louisonmalinge/Projet-Velux/Prototypage/BOM Projet Velux.xlsx

 |  |  |  |  |  |  |  | SOURCING |  |  |  |  |  | ACHATS
Référence | Description | Boitier | Fabricant | Part Number | Fournisseur | Réf fournisseur | Qty total | Fournisseur | Ref Four | Qté à Commander | Unit Price | Total Price | Sourceur | Commentaire | Acheteur | Commande | Datedecommande | Datelivraisonestimée | DateRéception
LMR51625YFDDCR (https://www.mouser.fr/ProductDetail/Texas-Instruments/LMR51625YFDDCR?qs=efUn273yAhe0Di9PgWnVVg%3D%3D) | Régulateurs de tension de commutation SIMPLE SWITCHER sync hronous buck conver |  | Texas Instruments (https://www.mouser.fr/manufacturer/texas-instruments/) | 296-LMR51625XDDCRCT-ND | digikey | LMR51625YFDDCR | 5 | digikey | LMR51625YFDDCR | 5 | 1.7100 € | 8.5500 € | Achat
RP73D2B10K2BTG (https://fr.farnell.com/holsworthy-te-connectivity/rp73d2b10k2btg/res-couche-mince-10k2-0-1-0-25w/dp/1501710RL) | Résistance à puce CMS, 10.2 kohm, ± 0.1%, 250 mW, 1206 [3216 Metric], Couche mince, Précision |  | HOLSWORTHY - TE CONNECTIVITY (https://fr.farnell.com/c/composants-passifs/resistances-valeur-fixe/resistances-cms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) |  | farnell | 1501710RL | 10 | farnell | 1501710RL | 10 | 0.6365 € | 6.3648 € | Achat
SPM4020T-4R7M-LR (https://fr.farnell.com/tdk/spm4020t-4r7m-lr/inductance-4-7uh-2-5a-20-bobinee/dp/2564035) | Inductance de puissance (CMS), Bobiné, 4.7 µH, 2.5 A, Blindé, 3.5 A, SPM-LR Series |  | TDX |  | farnell | 2564035 | 10 | farnell | 2564035 | 10 | 0.7046 € | 7.0464 € | Achat
C0603T104K4RACTU (https://fr.farnell.com/kemet/c0603t104k4ractu/condensateur-0-1-f-16v-10-x7r/dp/2904876) | Condensateur céramique multicouche CMS, 0.1 µF, 16 V, 0603 [Métrique 1608], ± 10%, X7R |  | KEMET |  | farnell | 2904876 | 10 | farnell | 2904876 | 10 | 0.3811 € | 3.8112 € | Achat
CGA4J3X7R1E225M125AE (https://fr.farnell.com/tdk/cga4j3x7r1e225m125ae/condensateur-2-2uf-25v-mlcc-0805/dp/4066733) | Condensateur céramique multicouche CMS, 2.2 µF, 25 V, 0805 [Métrique 2012], ± 20%, X7R |  | TDX |  | farnell | 4066733 | 5 | farnell | 4066733 | 5 | 0.3725 € | 1.8624 € | Achat
10 ensembles 20 ensembles lot 2.5MM pas 5264 (https://www.amazon.fr/bo%C3%AEtiers-femelles-aiguille-connecteur-fil-carte/dp/B0FRF74GVY?th=1) | Lot de 10/20 boîtiers femelles 5264 au pas 2,54 × 0,5 mm + aiguille droite/courbée + borne 2P à 12 broches 5268 for connecteur PCB fil-carte(Curver set-10sets,3P) |  | HamPaesk (https://www.amazon.fr/s/ref=bl_dp_s_web_0?ie=UTF8&search-alias=aps&field-keywords=HamPaesk) |  | Amazon |  | 1 | Amazon |  | 1 | 12.680 € | 12.6800 € | Achat
CRCW120653K6FKEA (https://fr.farnell.com/vishay/crcw120653k6fkea/res-couche-epaisse-53-6k-1-0-25w/dp/1653147) | Résistance à puce CMS, 53.6 kohm, ± 1%, 250 mW, 1206 [3216 Metric], Couche épaisse, Usage Général |  | VISHAY |  | farnell | 1653147 | 10 | farnell | 1653147 | 10 | 0.033 € | 0.3280 € | Achat
FCR7350R (https://www.digikey.com/en/products/detail/cliff-electronic-components-ltd/FCR7350R/17729035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) | 4MM PANEL SKT S16N-PC RED |  | CLIFF Electronic Components Ltd |  | digikey | 4654-FCR7350R-ND | 1 | digikey | 4654-FCR7350R-ND | 1 | 4.780 € | 4.7800 € | Achat
FCR7350B (https://www.digikey.com/en/products/detail/cliff-electronic-components-ltd/FCR7350B/17729030) | 4MM PANEL SKT S16N-PC BLACK |  | CLIFF Electronic Components Ltd |  | digikey | 4654-FCR7350B-ND | 1 | digikey | 4654-FCR7350B-ND | 1 | 4.780 € | 4.7800 € | Achat
RB141C1100 (https://www.digikey.fr/fr/products/detail/e-switch/RB141C1100/3778081) | Interrupteurs à bascule SPST 15A (CA) 125 V Montage sur panneau à enclenchement |  | E-Switch (https://www.digikey.fr/fr/supplier-centers/e-switch) |  | digikey | EG5637-ND | 1 | digikey | EG5637-ND | 1 | 0.850 € | 0.8500 € | Achat
820-7561 (https://ma.rsdelivers.com/product/rs-pro/commutateur-a-bouton-poussoir-spst-rs-pro-montage/8207561) | Commutateur à bouton-poussoir, SPST RS PRO, Montage sur circuit imprimé, Momentanée 13.6 mm IP40, LED Vert 50 V |  | RS PRO (https://ma.rsdelivers.com/productlist/search?query=rs%20pro) |  | RS Pro | 820-7561 | 1 | RS Pro | 820-7561 | 1 | 4.440 € | 4.4400 € | Achat
RUNCCI-YUN 60Pièces (https://www.amazon.fr/RUNCCI-YUN-60Pi%C3%A8ces-Femelle-Connecteur-Empilable/dp/B0FDQQ21SW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) | RUNCCI-YUN 60Pièces 2.54mm PCB Carte Femelle Broche Connecteur Socket (4/6/8/10/12/16/20/40 Pin) Femelle Pin Header Socket Connecteur Bande, pour Arduino Empilable Shield |  | RUNCCI-YUN (https://www.amazon.fr/RUNCCI-YUN/b?node=21909514031&field-lbr_brands_browse-bin=RUNCCI-YUN) |  | Amazon |  | 1 | Amazon |  | 1 | 9.990 € | 9.9900 € | Achat
GRM21BR61C226ME44L (https://fr.farnell.com/murata/grm21br61c226me44l/condensateur-22-f-16v-20-x5r-0805/dp/2688534) | CONDENSATEUR, 22µF, 16V, 20%, X5R, 0804 |  | MURATA |  | farnell | 2688534 | 10 | farnell | 2688534 | 10 | 0.284 € | 2.8416 € | Achat
Arduino Module nano 33 IOT (https://fr.farnell.com/arduino/abx00027/carte-dev-nano-33-iot-mcu-arm/dp/3404692) | ABX00027 |  | Arduino |  | farnell | 3404692 | 1 | farnell | 192-7585 | 1 | 17.584 € | 17.5840 € | Achat
 |  |  |  |  |  |  |  |  |  |  | Total | 85.91 €
