louisonmalinge/Projet-Velux/Prototypage/Choix des composants.xlsx

Sheet: Feuil2
Nom | Référence | Lien | Nombre | Prix
Convertisseur Buck | LMR51625XFDDCR | LMR51625XFDDCR Texas Instruments | Mouser France (https://www.mouser.fr/ProductDetail/Texas-Instruments/LMR51625XFDDCR?qs=efUn273yAhedqu6JOAiMBw%3D%3D) | 1 | 2.69 € | Prix totale | 56.07 €
Condensateur | C2012X5R1A336M125AC | C2012X5R1A336M125AC TDK, Condensateur céramique multicouche CMS, 33 µF, 10 V | Farnell® France (https://fr.farnell.com/tdk/c2012x5r1a336m125ac/condensateur-33-f-10v-20-x5r-0805/dp/2525132) | 2 | 1,71 €
Résistance | MCWF12R3162BTL Résistance à puce CMS, 31.6 kohm, ± 0.1%, 250 mW, 1206 [3216 Metric], Couche mince, Précision | MCWF12R3162BTL MULTICOMP PRO, Résistance à puce CMS, 31.6 kohm, ± 0.1% | Farnell® France (https://fr.farnell.com/multicomp-pro/mcwf12r3162btl/res-couche-mince-31-6k-0-1-0-25w/dp/2338454) | 1 | 1.84 €
Résistance | RP73D2B10K2BTG Résistance à puce CMS, 10.2 kohm, ± 0.1%, 250 mW, 1206 [3216 Metric], Couche mince, Précision | RP73D2B10K2BTG HOLSWORTHY - TE CONNECTIVITY, Résistance à puce CMS, 10.2 kohm, ± 0.1% | Farnell® France (https://fr.farnell.com/holsworthy-te-connectivity/rp73d2b10k2btg/res-couche-mince-10k2-0-1-0-25w/dp/1501710RL) | 1 | 0.37 €
Bobine | B82477G4103M000 Inductance de puissance (CMS), 10 µH, 5.4 A, Blindé, 6.4 A, B82477G4 Series | B82477G4103M000 EPCOS, Inductance de puissance (CMS), 10 µH, 5.4 A | Farnell® France (https://fr.farnell.com/epcos/b82477g4103m000/inductance-de-puissance-10uh/dp/7430353) | 1 | 1.63 €
Condensateur | C0603T104K4RACTU Condensateur céramique multicouche CMS, 0.1 µF, 16 V, 0603 [Métrique 1608], ± 10%, X7R | C0603T104K4RACTU KEMET, Condensateur céramique multicouche CMS, 0.1 µF, 16 V | Farnell® France (https://fr.farnell.com/kemet/c0603t104k4ractu/condensateur-0-1-f-16v-10-x7r/dp/2904876) | 1 | 0.44 €
Condensateur | CS1206KKX7R8BB225 Condensateur céramique multicouche CMS, 2.2 µF, 25 V, 1206 [Métrique 3216], ± 10%, X7R | CS1206KKX7R8BB225 YAGEO, Condensateur céramique multicouche CMS, 2.2 µF, 25 V | Farnell® France (https://fr.farnell.com/yageo/cs1206kkx7r8bb225/condensateur-2-2uf-25v-mlcc-1206/dp/3890070) | 1 | 0.22 €
Interrupteur | Interrupteur à bascule unipolaire On-Off, , 16 A | PRASA1-16F-BB0BW | Interrupteur à bascule unipolaire On-Off, , 16 A | RS (https://fr.rs-online.com/web/p/interrupteurs-a-bascule/7182247) | 1 | 1.83 €
Bouton Poussoir | Bouton-poussoir, Momentané, SPST, 65 mA, Montage panneau | FL13NN | Bouton-poussoir, Momentané, SPST, 65 mA, Montage panneau | RS (https://fr.rs-online.com/web/p/boutons-poussoirs/9131762) | 1 | 8.56 €
Écran OLED | MDOB128064WV-YBI OLED graphique, 128 x 64 pixels, jaune/bleu sur noir, 3.3V, I2C, 27.3mm x 27.3mm, -40 °C | MDOB128064WV-YBI MIDAS DISPLAYS, OLED graphique, 128 x 64 pixels, jaune/bleu sur noir | Farnell® France (https://fr.farnell.com/midas/mdob128064wv-ybi/oled-graphique-cob-128-x-64-pixels/dp/3565084) | 1 | 12.74 €
Connecteur( arduino/module ethernet/écran) | VooGenzek 120 Pièces 2.54mm PCB Carte Femelle Broche Connecteur Socket Kit, Pin Header Socket Bande, pour Arduino Empilable Shield (4/6/8/10/12/16/20/40 Pin) | https://www.amazon.fr/VooGenzek-Femelle-Connecteur-Arduino-Empilable/dp/B09NDMVD2C?hvadid=80470714387312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 | 1 | 11.99 €
Conecteur cable banane noir | SWEB 8094 AU / SW Connecteur de test banane, Femelle, Montage PCB, 24 A, 1 kV, Contacts plaqués or, Noir | SWEB 8094 AU / SW SCHUTZINGER, Connecteur de test banane, Femelle, Montage PCB | Farnell® France (https://fr.farnell.com/schutzinger/sweb-8094-au-sw/conn-banane-femelle-24a-noir/dp/3224814) | 1 | 6.20 €
Conecteur cable banane rouge | SWEB 8094 AU / RT Connecteur de test banane, Femelle, Montage PCB, 24 A, 1 kV, Contacts plaqués or, Rouge | SWEB 8094 AU / RT SCHUTZINGER, Connecteur de test banane, Femelle, Montage PCB | Farnell® France (https://fr.farnell.com/schutzinger/sweb-8094-au-rt/fiche-banane-femelle-24a-rouge/dp/3224813) | 1 | 6.20 €
Connecteur Panneau Solaire | 10 ensembles 20 ensembles lot 2.5MM pas 5264 boîtier femelle + aiguille droite/incurvée + Terminal 2P ~ 12P 5268 pour connecteur fil à carte PCB (https://fr.aliexpress.com/item/1005003049892868.html?gatewayAdapt=kor2fra) | 10 ensembles 20 ensembles lot 2.5MM pas 5264 boîtier femelle + aiguille droite/incurvée + Terminal 2P ~ 12P 5268 pour connecteur fil à carte PCB - AliExpress 13 (https://fr.aliexpress.com/item/1005003049892868.html?gatewayAdapt=kor2fra) | 1 | 1.35 €
 |  | Connecteur 2 cosses avec broches mâle et femelle Brazoline - Atelier & Stand sur La Bécanerie (https://www.la-becanerie.com/connecteur-2-cosses-avec-broches-male-et-femelle-brazoline.html)

Sheet: Feuil1
Référence | Lien
