louisonmalinge/Projet-Velux/Plan de test/Fiche anomalie/Prcoédure de test Wireshark.pdf

### Brevet de Technicien Supérieur CIEL

Session 2026
Saint Aubin la Salle

# Procédure de test WIRESHARK

# MALINGE Louison ST2ER

1. Ouvrir l’application Wireshark sur le PC et éteindre le banc de test en appuyant sur l’interrupteur situé sur la face avant du banc de test.

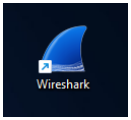
[picture p37: figure]

2. Une fois ouverte, cliquer sur Ethernet :

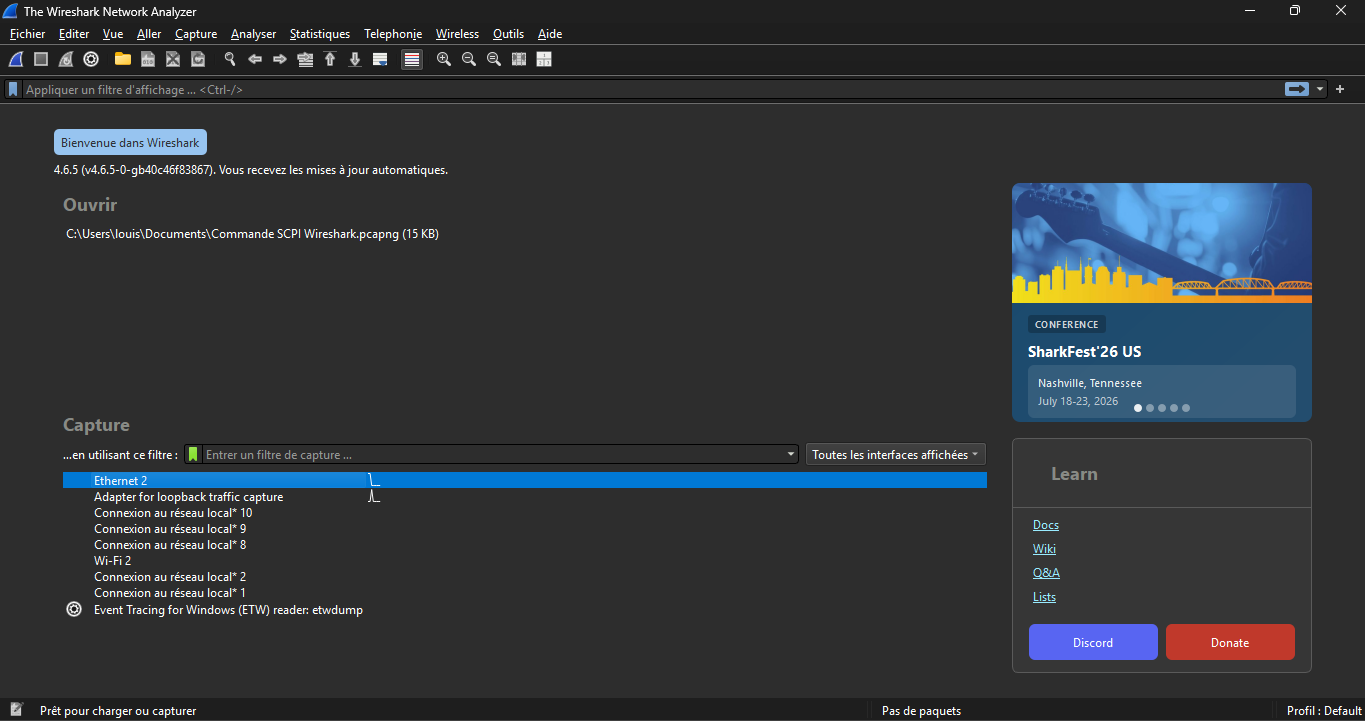
[picture p38: figure]
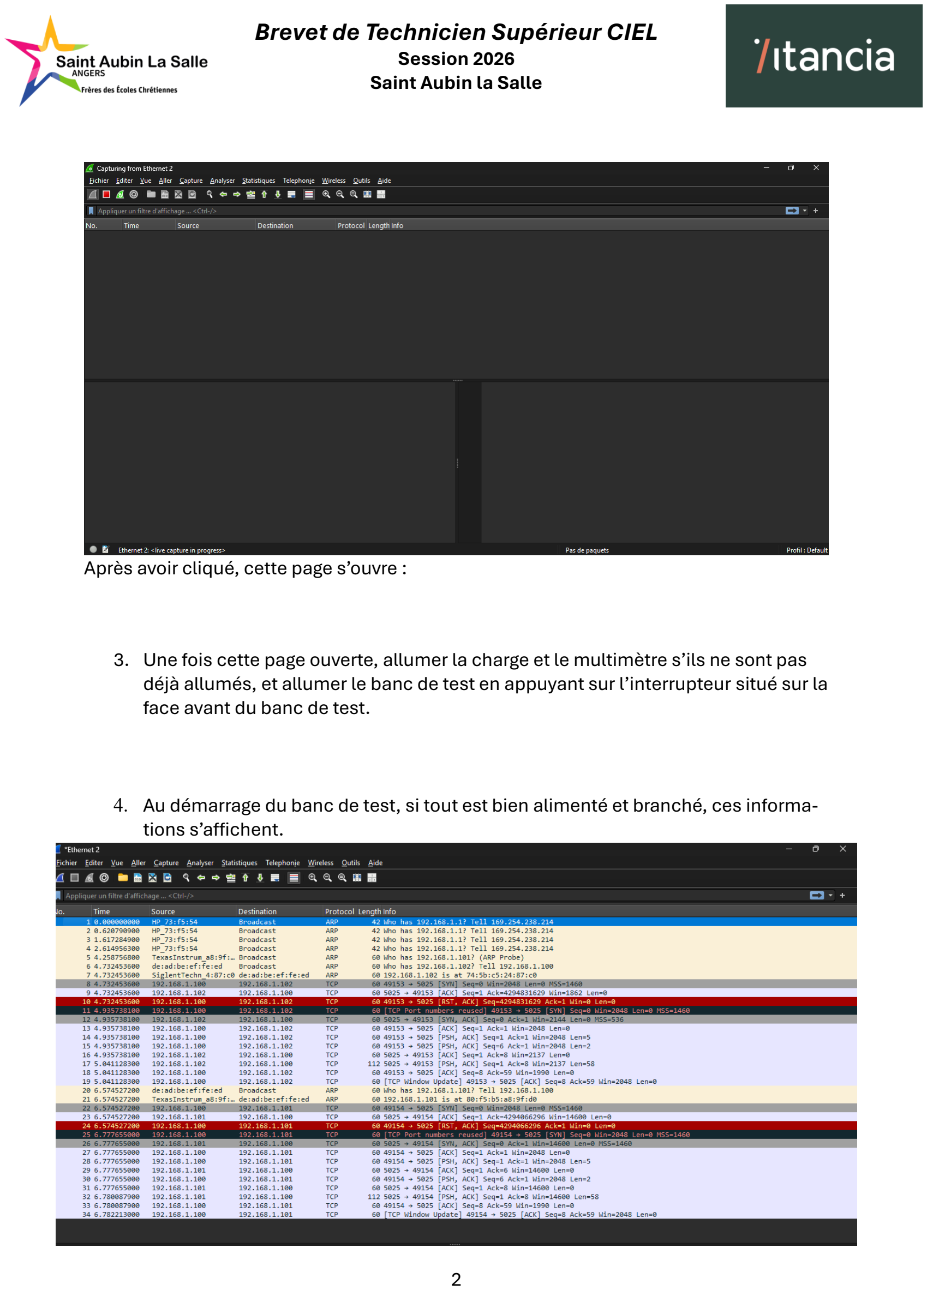
[picture p39: page 2]

Après avoir cliqué, cette page s’ouvre :

3. Une fois cette page ouverte, allumer la charge et le multimètre s’ils ne sont pas déjà allumés, et allumer le banc de test en appuyant sur l’interrupteur situé sur la face avant du banc de test.
4. Au démarrage du banc de test, si tout est bien alimenté et branché, ces informations s’affichent.

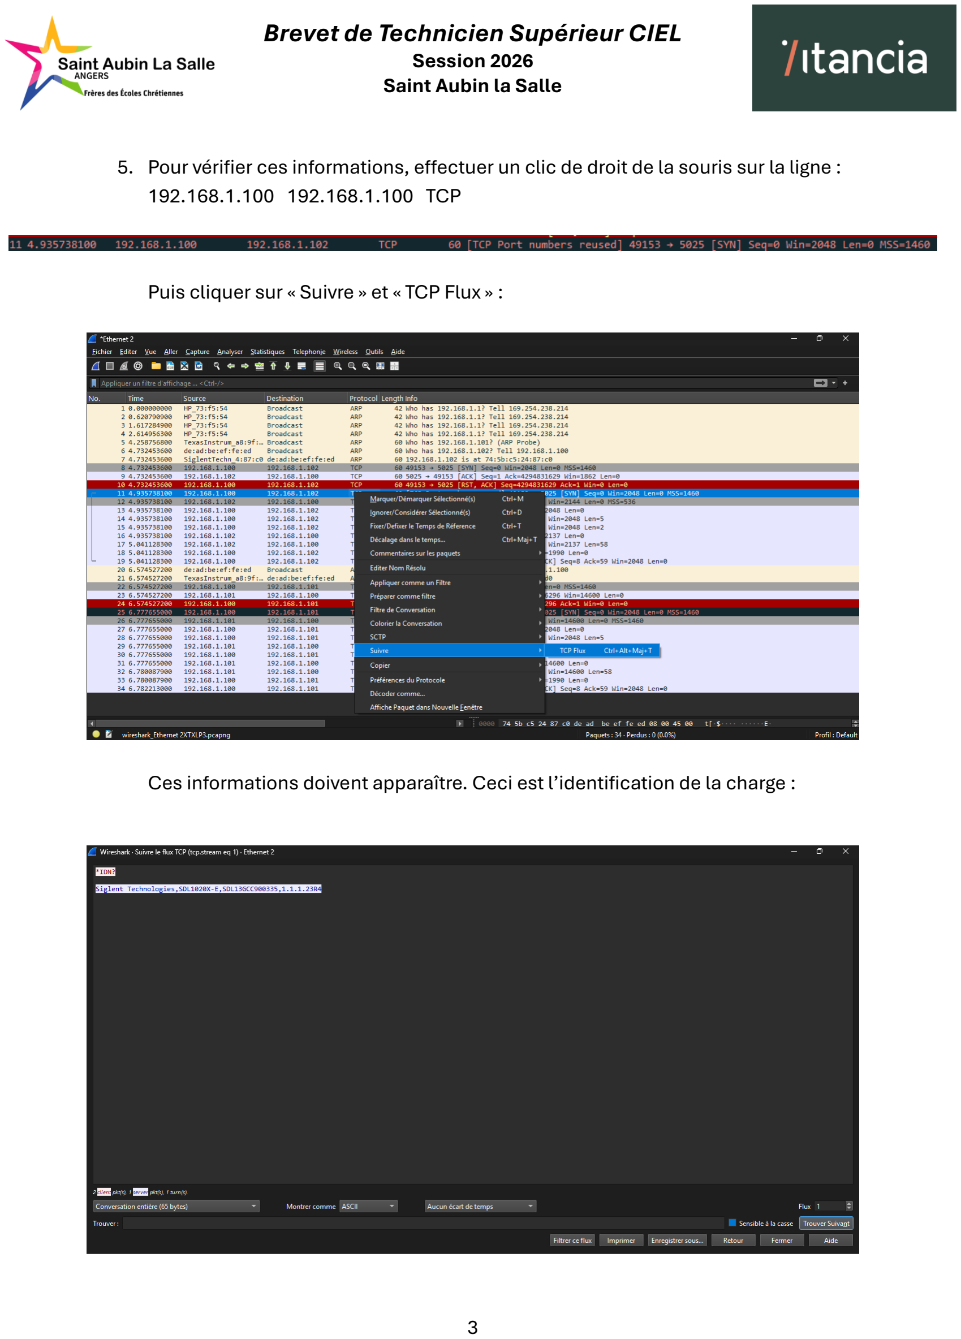
[picture p40: page 3]

5. Pour vérifier ces informations, effectuer un clic de droit de la souris sur la ligne : 192.168.1.100 192.168.1.100 TCP

Puis cliquer sur « Suivre » et « TCP Flux » :

Ces informations doivent apparaître. Ceci est l’identification de la charge :

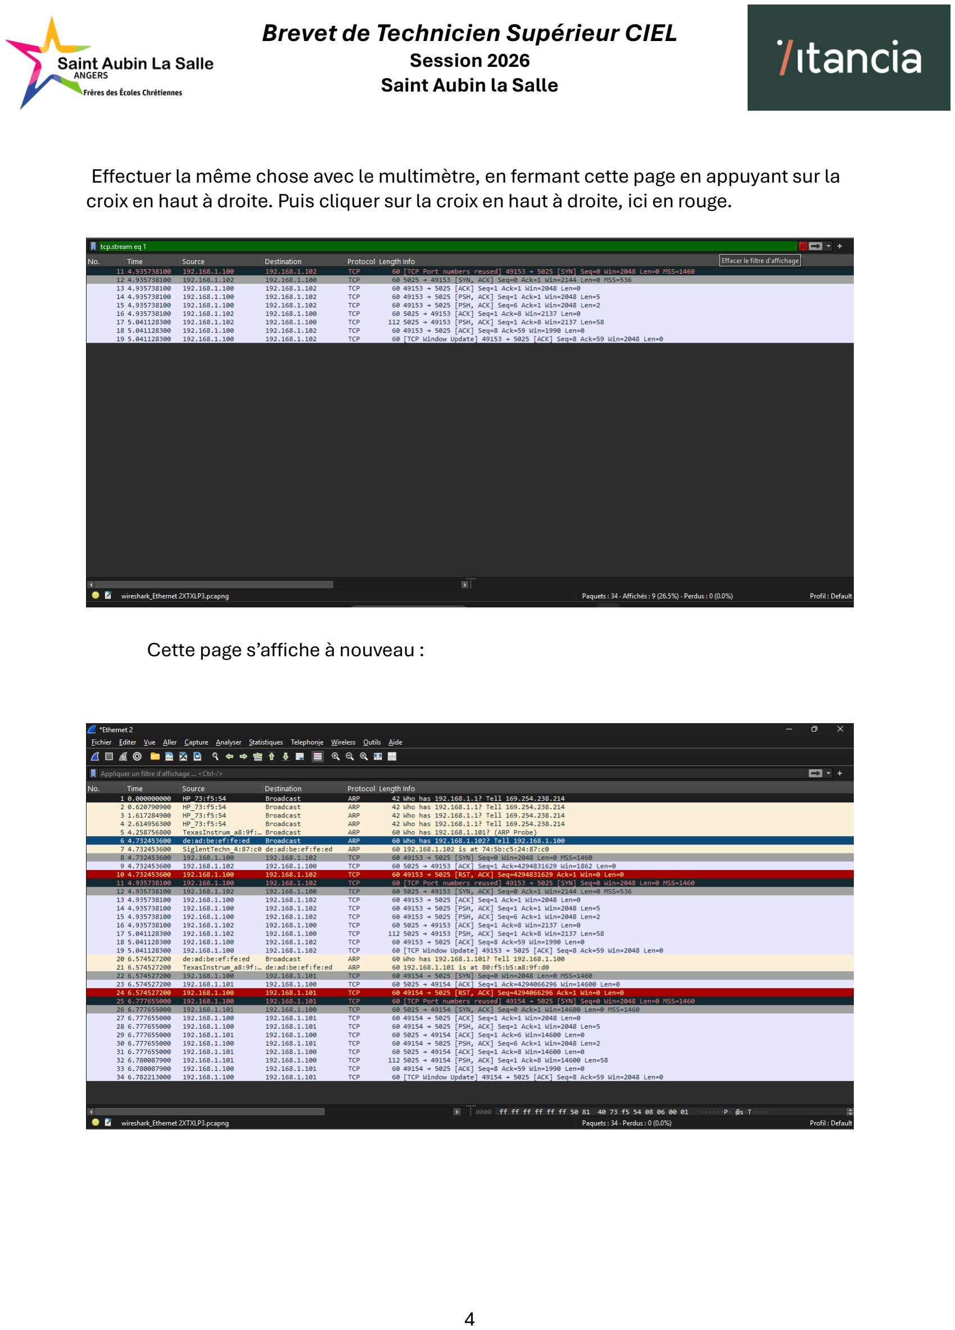
[picture p41: page 4]

Effectuer la même chose avec le multimètre, en fermant cette page en appuyant sur la croix en haut à droite. Puis cliquer sur la croix en haut à droite, ici en rouge.

Cette page s’affiche à nouveau :

Effectuer la même procédure que précédemment en effectuant un clic droit sur la deuxième ligne en noir. Puis « Suivre », « TCP Flux » et obtenir cette page :

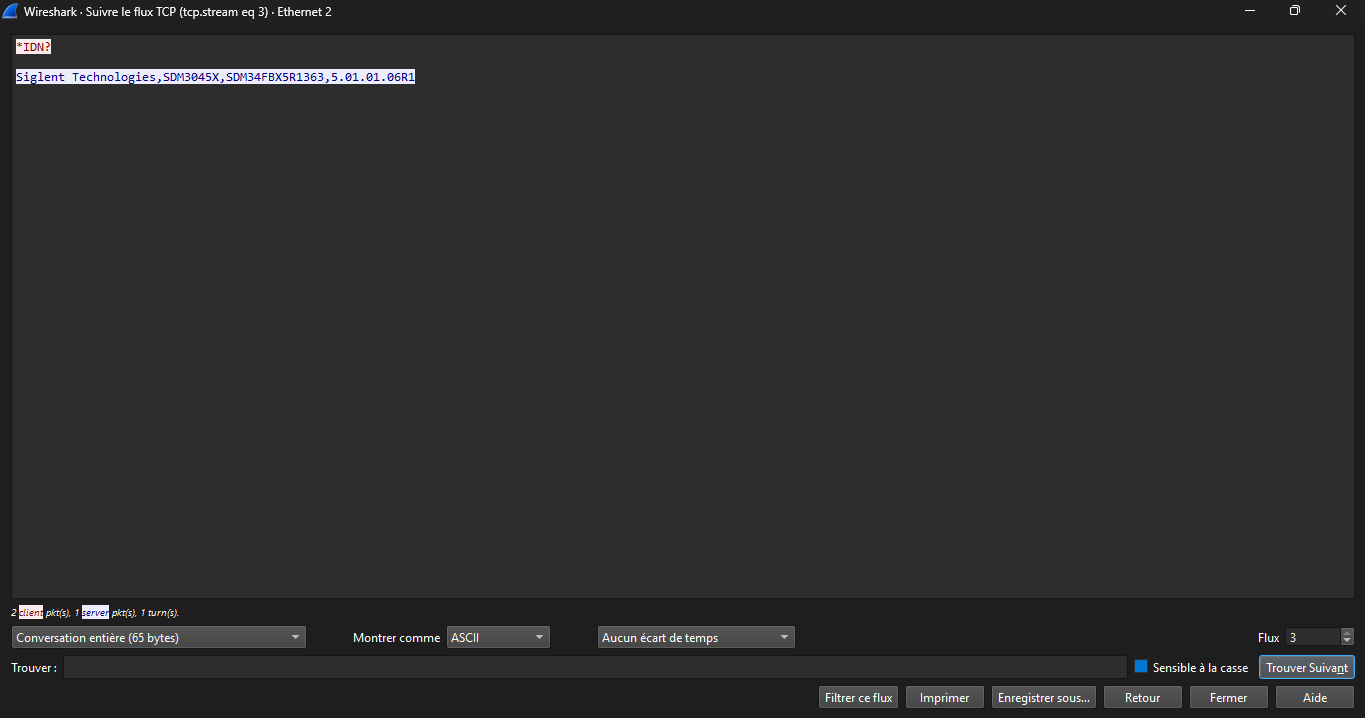
[picture p42: figure]

Ces informations sont l’identification du multimètre.

Puis fermer cette page comme précédemment pour revenir à cette page :

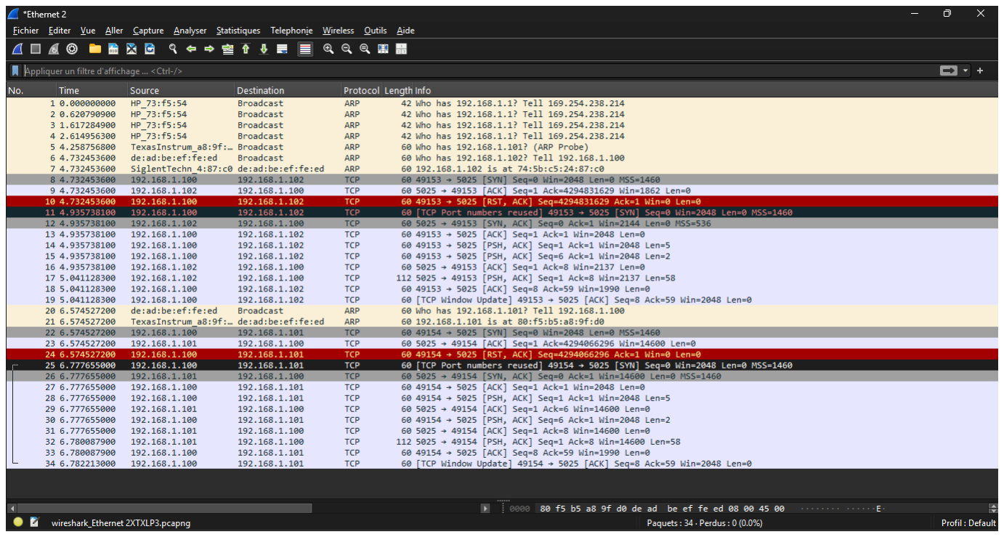
[picture p43: figure]

6. Ce résultat prouve que Wireshark arrive à lire la donnée envoyée par le module Ethernet du banc de test vers les appareils de mesure SIGLENT (Charge et Multimètre).
Maintenant, brancher un panneau solaire au banc de test et lancer le test en pressant le bouton poussoir situé sur la face avant du banc de test.

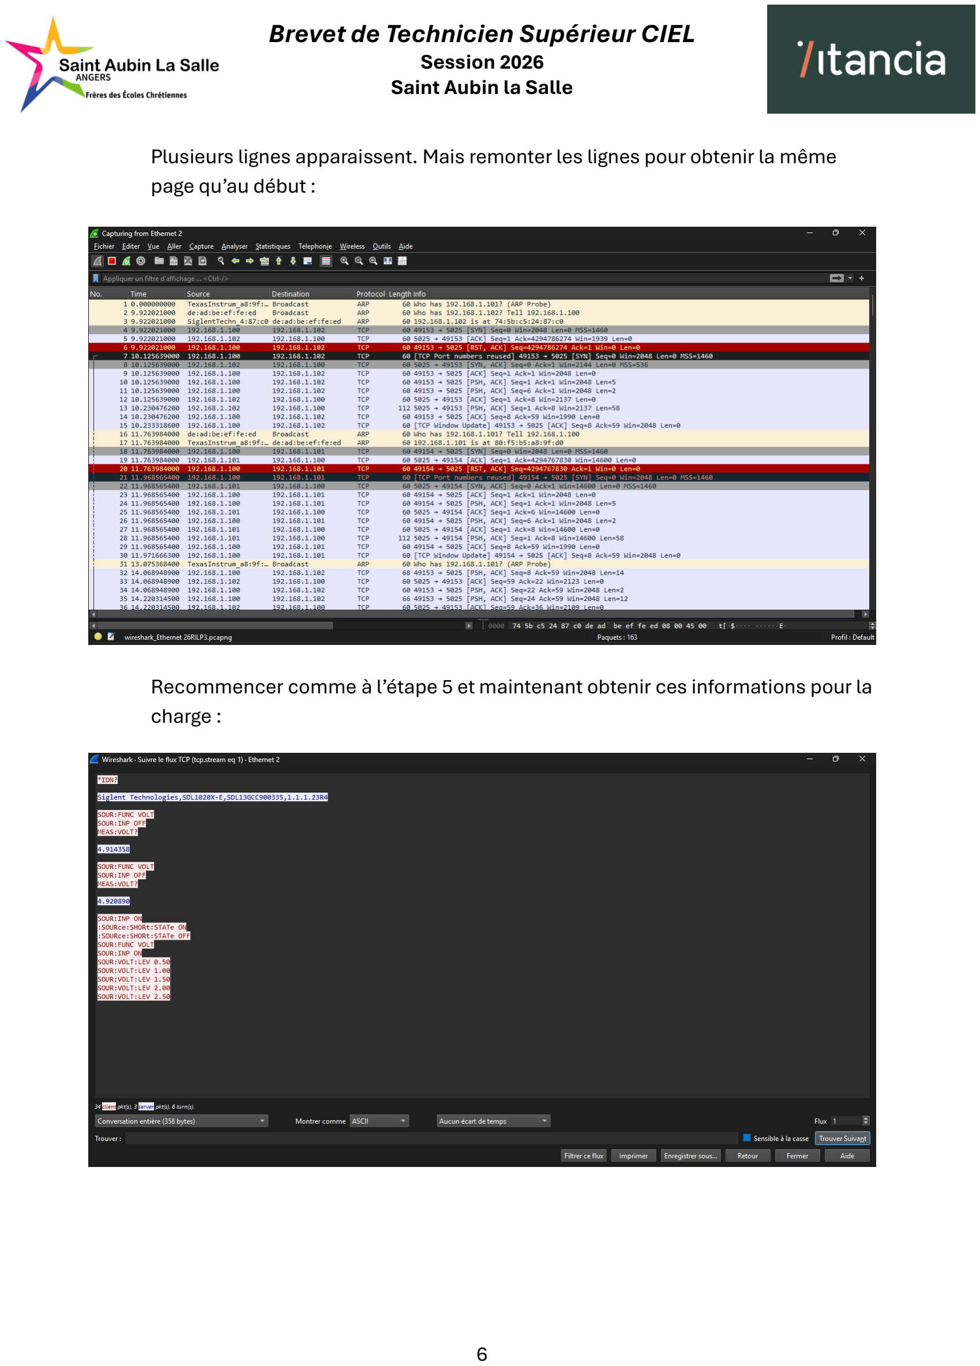
[picture p44: page 6]

Plusieurs lignes apparaissent. Mais remonter les lignes pour obtenir la même page qu’au début :

Recommencer comme à l’étape 5 et maintenant obtenir ces informations pour la charge :

Et ces informations pour le multimètre :

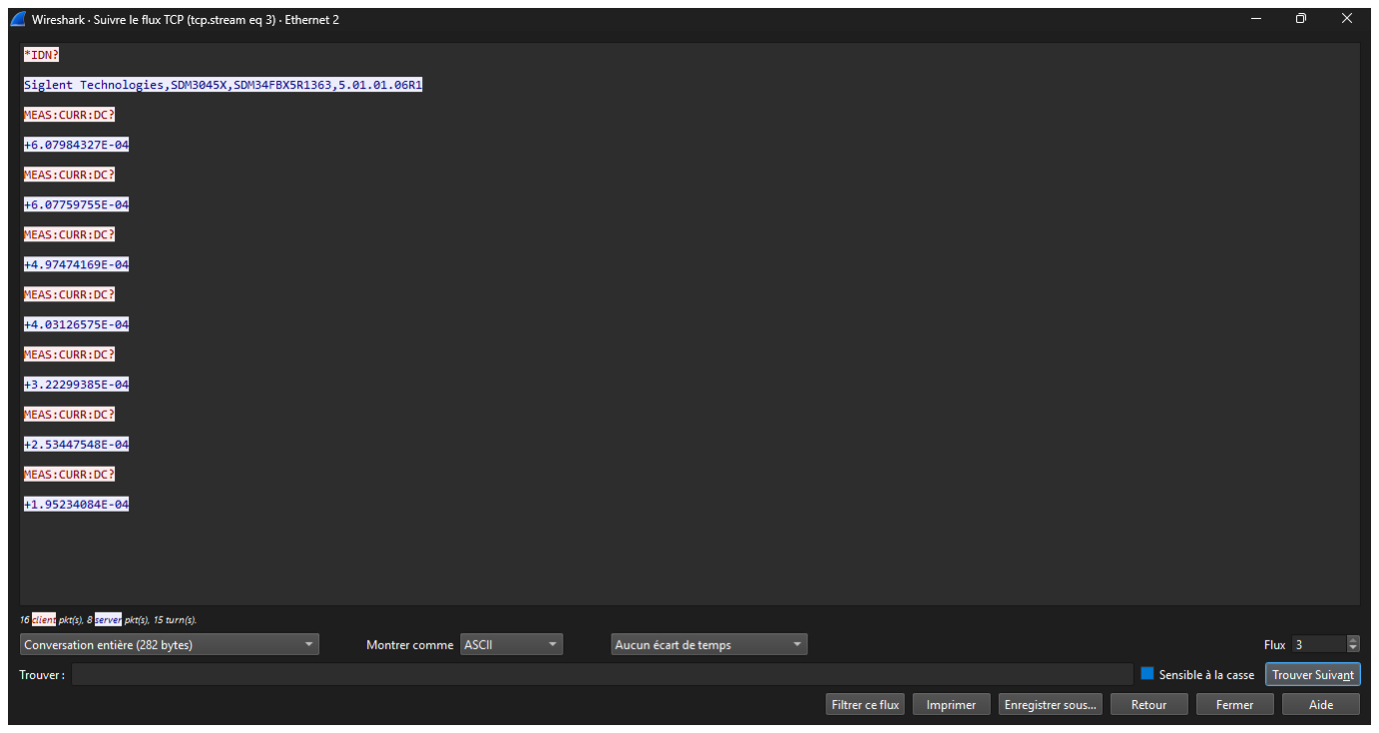
[picture p45: figure]

En rouge les données envoyées par le PCB du banc de test vers les appareils de mesure.
En bleu les données envoyées par les appareils de mesure vers le PCB du banc de test.

Par conséquent les données en bleu varient en fonction de l’état du panneau solaire.

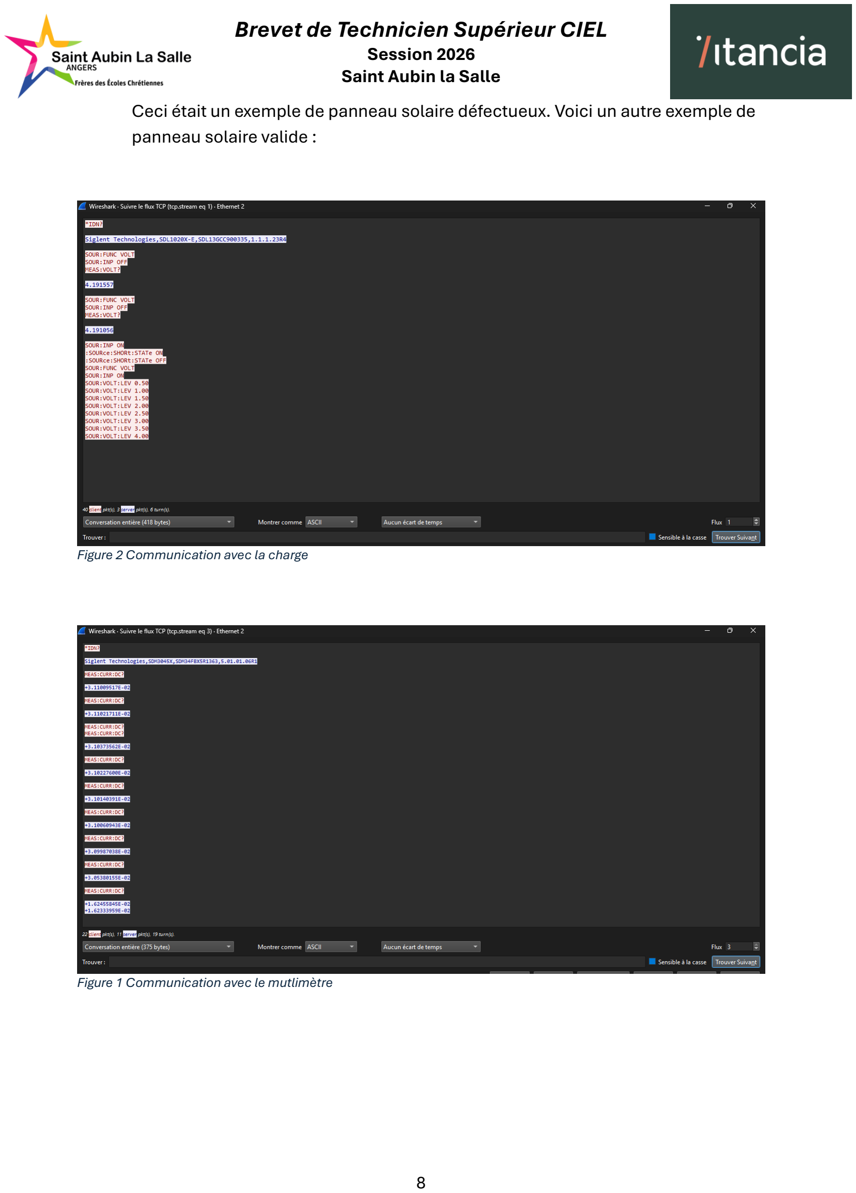
[picture p46: page 8]

Ceci était un exemple de panneau solaire défectueux. Voici un autre exemple de panneau solaire valide :

Figure 2 Communication avec la charge

Figure 1 Communication avec le mutlimètre
