louisonmalinge/Projet-Velux/Test panneau photovoltaique.xlsx

Tension (V) | Courant (mA) | Puissance (mW)
1 | 1.5 | 1.5
2 | 1.24 | 2.48 |  |  |  |  |  | Extérieur (bon ensoleillement, 500W/m²) |  |  |  | Intérieur
3 | 1.01 | 3.03 |  |  |  |  |  | Panneau 1 | Panneau 2 | Panneau 3 | Panneau 4 | Panneau 1 | Panneau 2 | Panneau 3 | Panneau 4
4 | 0.81 | 3.24 | Open-circuit Voltage (tout éteint) | Uoc [V] | 11.94 | 23.4 | 16.12 | 14.35 | 4.6 | 15.4 | 11.12 | 16.71 | 4.5 | 16.26 | 13.11 | 16.7
5 | 0.65 | 3.25 | Short-circuit current (short et on/off allumé) | Isc [mA] | 1.8 | 87.9 | 7.68 | 19.1 | 1.7 | 6.66 | 2.81 | 8.28 | 0.6 | 3.75 | 1.73 | 8
6 | 0.51 | 3.06 | Voltage at nominal power | Umpp [V] | 5 | 17.8 | 5.5 | 5 | 2 | 5 | 4 | 5 | 2 | 6 | 5 | 6
7 |  | 0 | Current at nominal power | Impp [mA] | 0.65 | 76.5 | 4.2 | 8.84 | 0.7 | 2.96 | 1.32 | 4.98 | 0.253 | 1.56 | 0.73 | 4.12
8 |  | 0 | Nominal power | Pmpp [mW] | 3.2 | 1361.7 | 23.1 | 44.2 | 1.4 | 14.8 | 5.28 | 24.9 | 0.506 | 9.36 | 3.65 | 24.72
9 |  | 0 | Fill Factor | FF | 0.15 | 0.6620285289 | 0.1865888648 | 0.1612638415 | 0.179028133 | 0.1443001443 | 0.1689751402 | 0.1799668687 | 0.1874074074 | 0.1535055351 | 0.1609326155 | 0.1850299401
10 |  | 0
11 |  | 0
12 |  | 0
13 |  | 0
14 |  | 0
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
