louisonmalinge/Projet-Velux/Kicad/Projet Velux.kicad_pcb

## KiCad design Kicad/Projet Velux.kicad_pcb (2026-03-29)

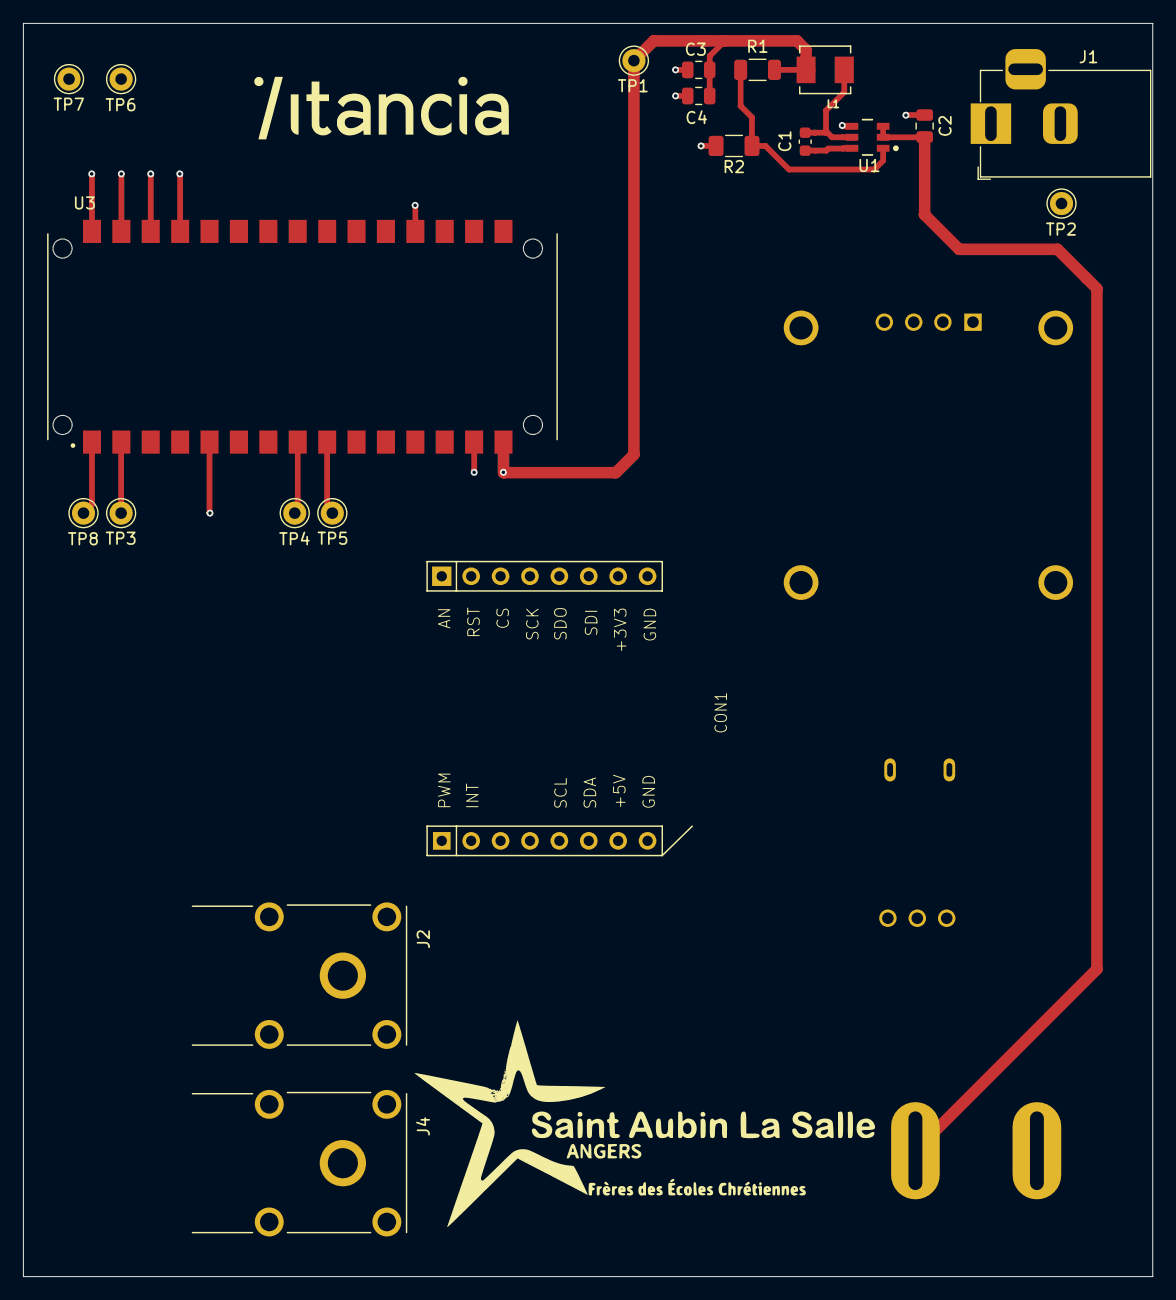
[picture p50: board Projet Velux.kicad_pcb from above]

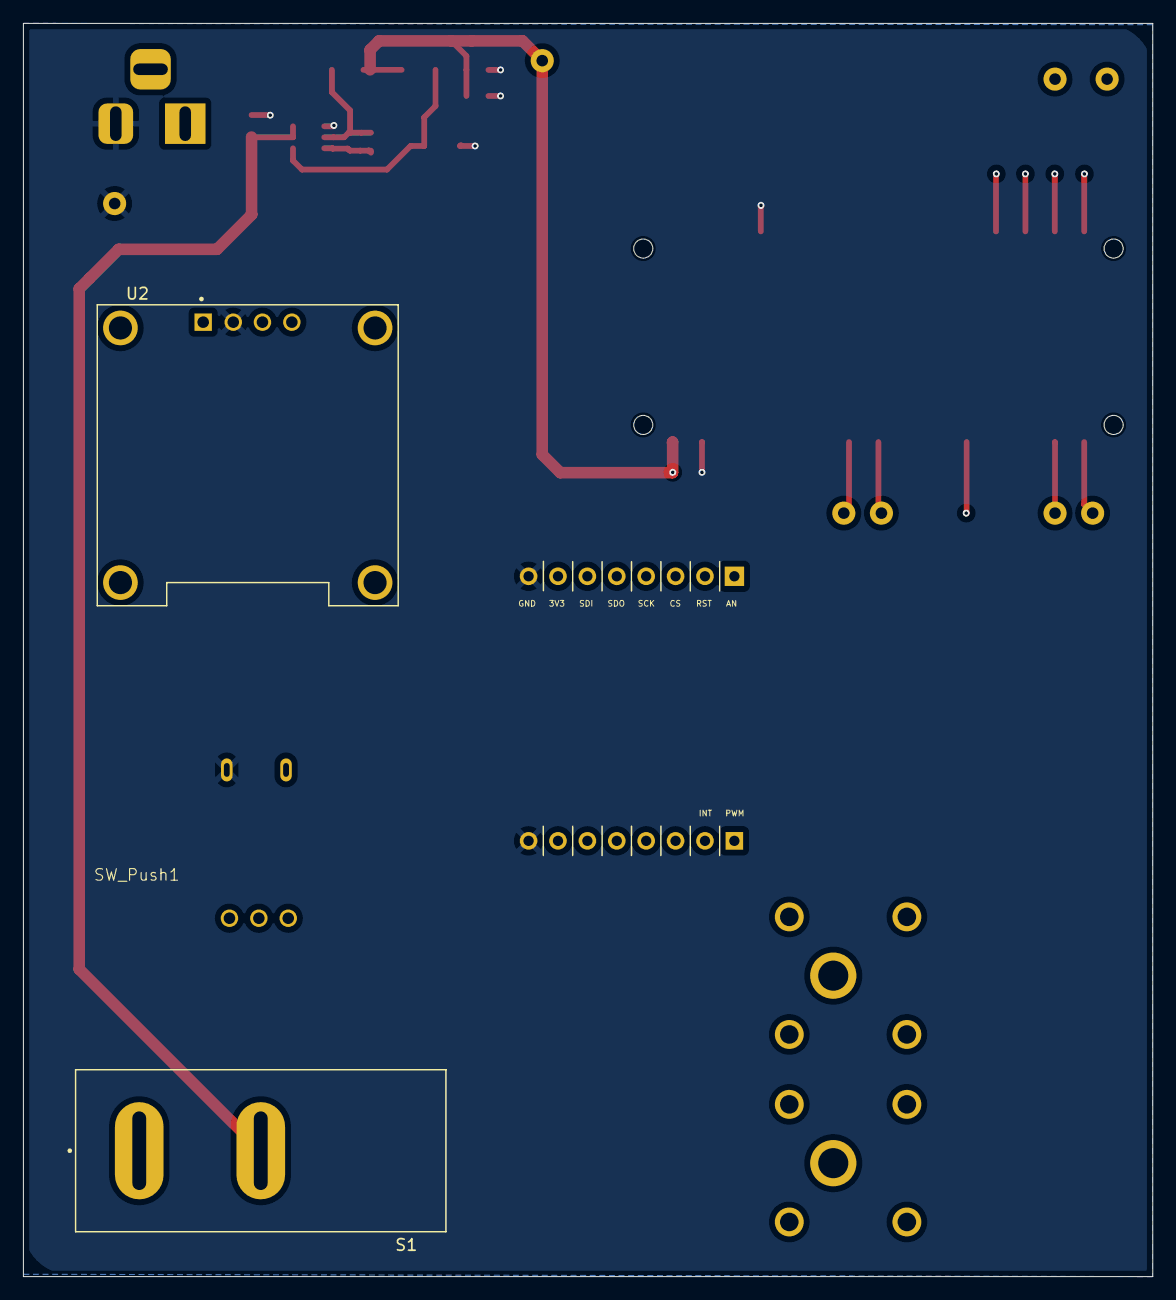
[picture p51: board Projet Velux.kicad_pcb from below]

Board: 4 copper layers, 97.6 x 108.3 mm, 25 parts (5 on the bottom side), 18 nets.

Parts:
C1: 0.1µF; C_0603_1608Metric
C2: 2.2µF; C_0805_2012Metric
C3, C4: 22µF; C_0805_2012Metric
CON1: MIKROBUS_MODULE_CONN
J1: Connecteur Alimentation; BarrelJack_Horizontal
J2: FCR7350R; FCR7350
J3: Connecteur Panneau Solaire; Connecteur panneau solaire
J4: FCR7350B; FCR7350
L1: 4.7µH; IND_SPM4020T-4R7M-LR
R1: 53.6k; R_1206_3216Metric
R2: 10.2k; R_1206_3216Metric_Pad1.30x1.75mm_HandSolder
S1: RB141C1100; SW_RB141C1100
SW_Push1: SW_Push; Bouton poussoir
TP1, TP2, TP3, TP4, TP5, TP6, TP7, TP8: TestPoint; Pin_D1.0mm_L10.0mm
U1: LMR51625YFDDCR; DDC0006A-MFG
U2: DM-OLED096-636; MODULE_DM-OLED096-636
U3: ABX00027; MODULE_ABX00027

Connections:
+3.3V: CON1.P7 (3V3), TP3.1, U2.2 (VCC_IN), U3.2 (+3V3)
+5V: C3.1, C4.1, L1.2, R1.1, TP1.1, U3.15 (VIN)
+24V: J1.1, S1.1
/A1: SW_Push1.2, U3.5 (A1)
/CS: CON1.P3 (CS), U3.28 (D10/PWM)
/MISO: CON1.P5 (MISO), TP7.1, U3.30 (D12/MISO)
/MOSI: CON1.P6 (MOSI), TP6.1, U3.29 (D11/MOSI)
/RST: CON1.P2 (RST), U3.27 (D9/PWM)
/SCK: CON1.P4 (SCK), TP8.1, U3.1 (D13)
/SCL: TP5.1, U2.3 (SCL), U3.9 (A5/SCL)
/SDA: TP4.1, U2.4 (SDA), U3.8 (A4/SDA)
/switch: C2.1, S1.2, U1.2 (EN), U1.3 (VIN)
GND: C2.2, C3.2, C4.2, CON1.P8 (GND1), CON1.P9 (GND2), J1.2, R2.2, SW_Push1.1, TP2.1, U1.4 (GND), U2.1 (GND), U3.14 (GND), U3.19 (GND)
unnamed: J2.P$1, J2.P$2, J2.P$3, J2.P$4, J2.P$5, J3.1
unnamed: J3.3, J4.P$1, J4.P$2, J4.P$3, J4.P$4, J4.P$5
unnamed: C1.1, U1.6 (CB)
unnamed: R1.2, R2.1, U1.1 (FB)
unnamed: C1.2, L1.1, U1.5 (SW)
